robyscar/shagmatic/PICS/power-electronics_box_signal_side.jpg

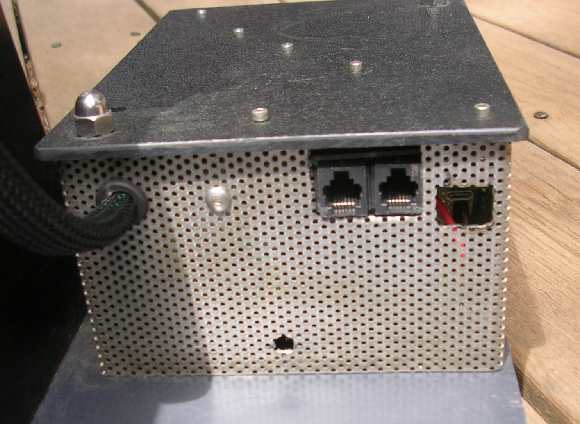
PICS/power-electronics_box_signal_side.jpg
