robyscar/shagmatic/PICS/power_supply_electronics_box_power_entry.jpg

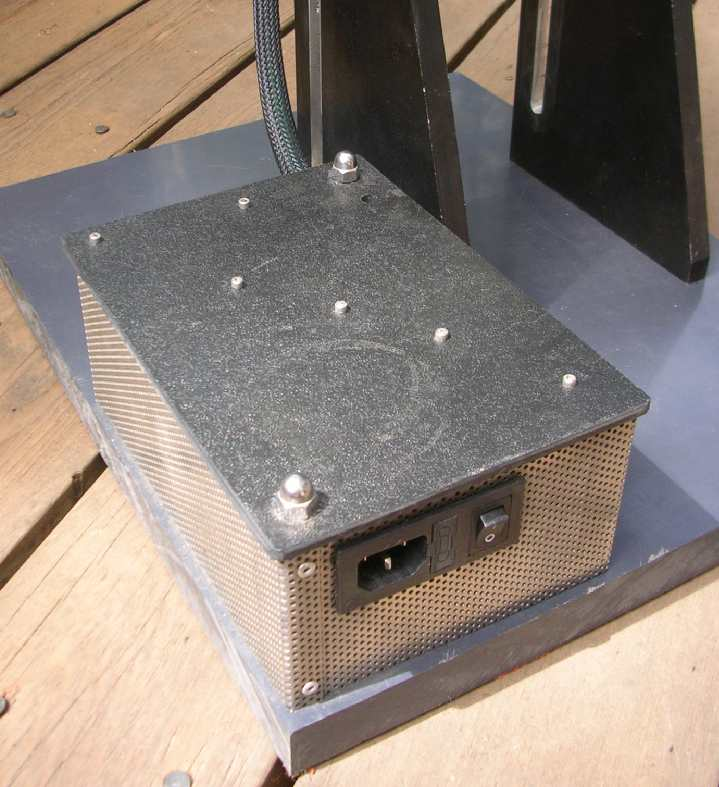
PICS/power_supply_electronics_box_power_entry.jpg
