robyscar/shagmatic/PICS/base.jpg

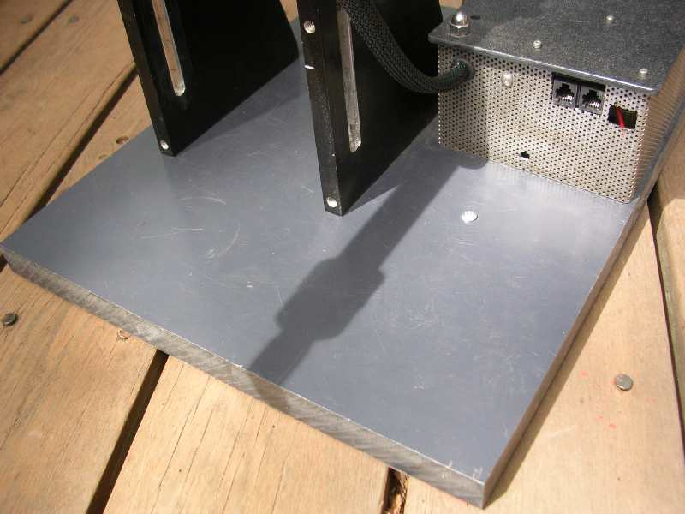
PICS/base.jpg
