robyscar/shagmatic/PICS/clamp_lever.jpg

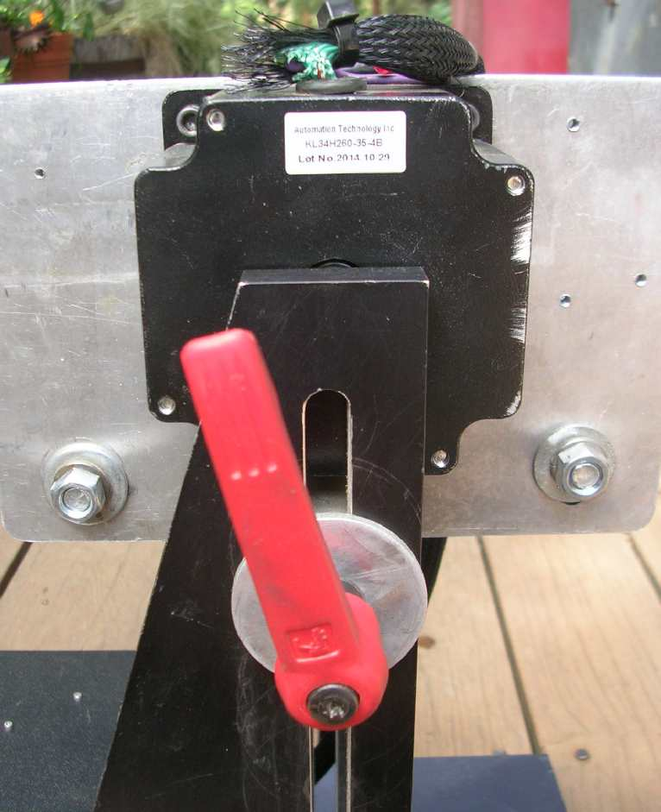
PICS/clamp_lever.jpg
