robyscar/shagmatic/PICS/drive_wheel_limit_switches.jpg

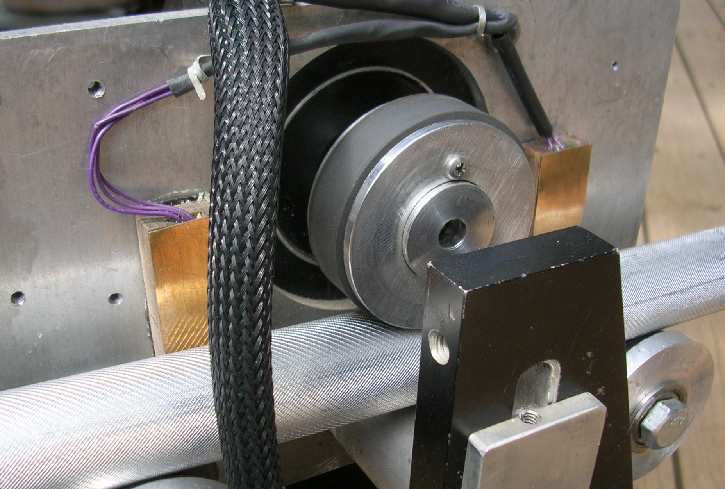
PICS/drive_wheel_limit_switches.jpg
