robyscar/shagmatic/PICS/DSCN2283.jpg

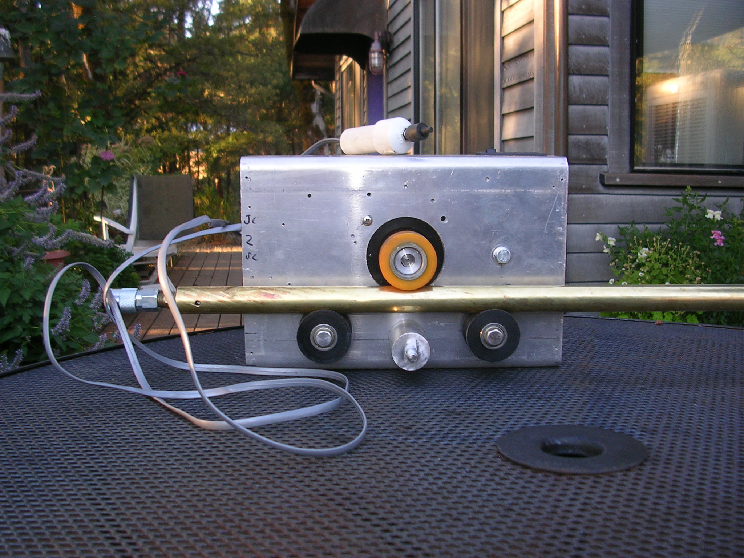
PICS/DSCN2283.jpg
