robyscar/shagmatic/PICS/DSCN2285.jpg

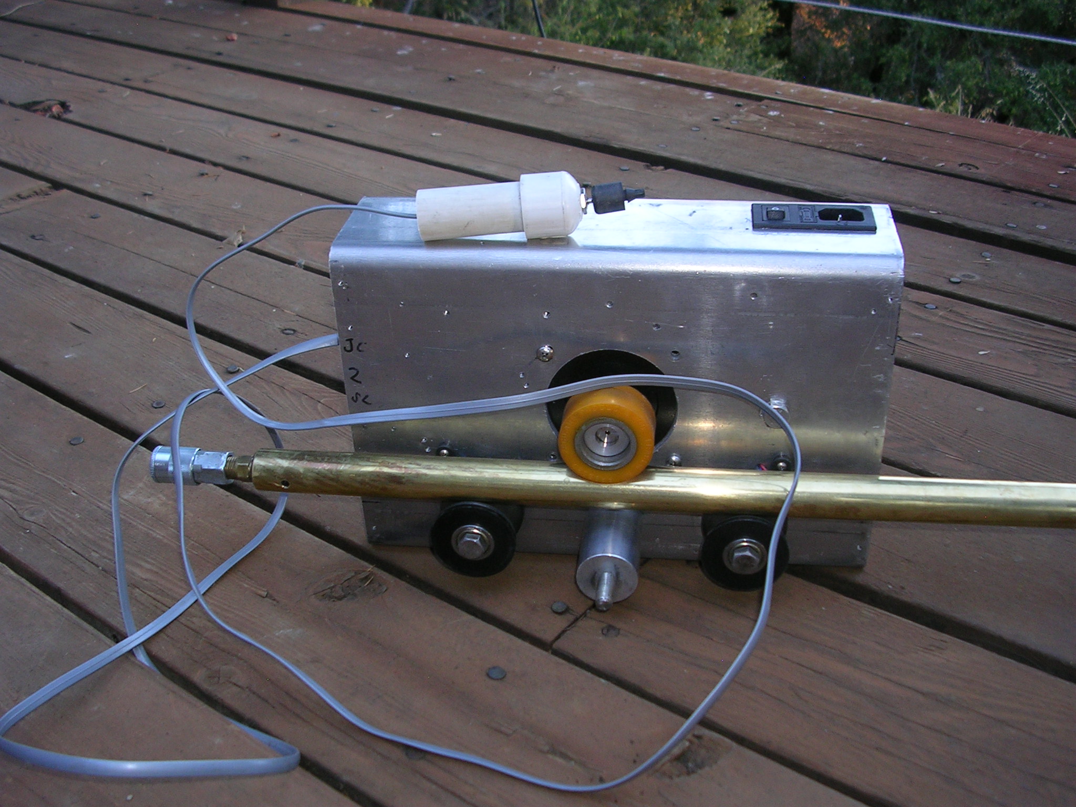
PICS/DSCN2285.jpg
