robyscar/shagmatic/PICS/full_machine_side_1.jpg

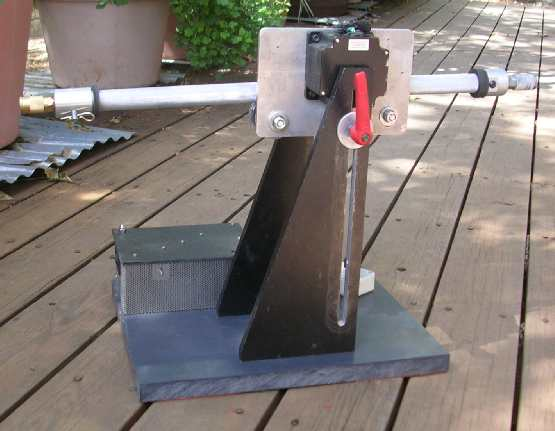
PICS/full_machine_side_1.jpg
