robyscar/shagmatic/PICS/full_machine_side_2 (1).jpg

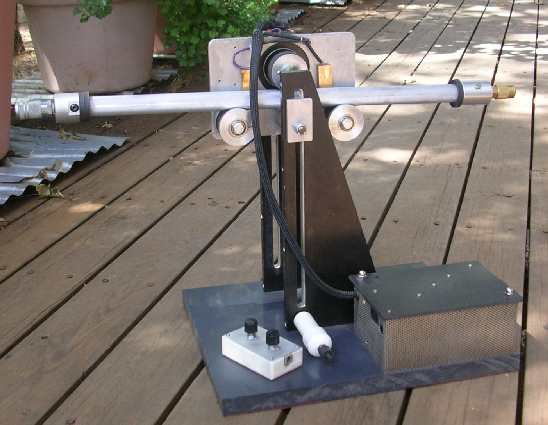
PICS/full_machine_side_2 (1).jpg
