robyscar/shagmatic/PICS/hf-stand2.jpg

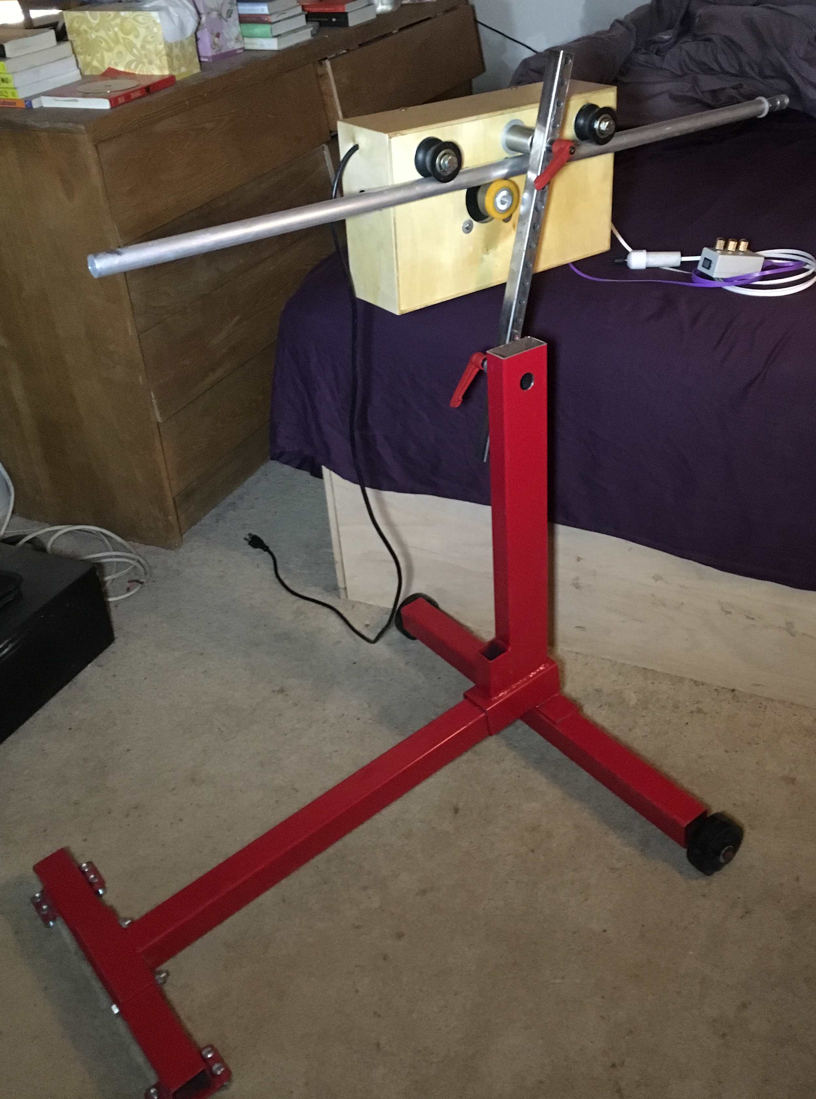
PICS/hf-stand2.jpg
