robyscar/shagmatic/PICS/IMG_1693.jpg

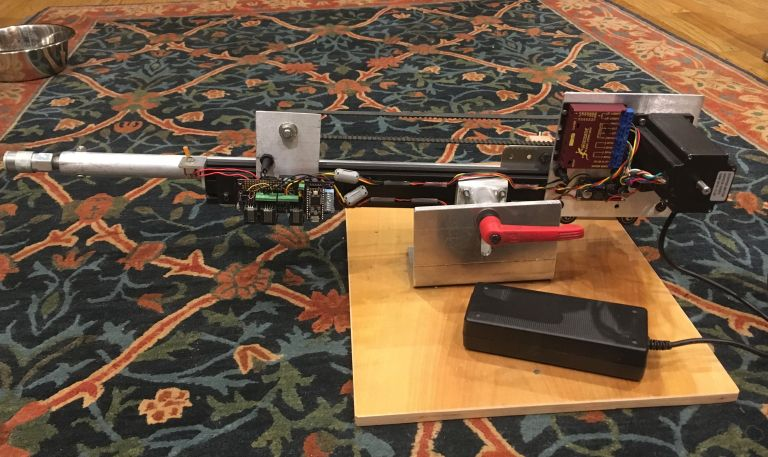
PICS/IMG_1693.jpg
