robyscar/shagmatic/PICS/IMG_1980-small.jpg

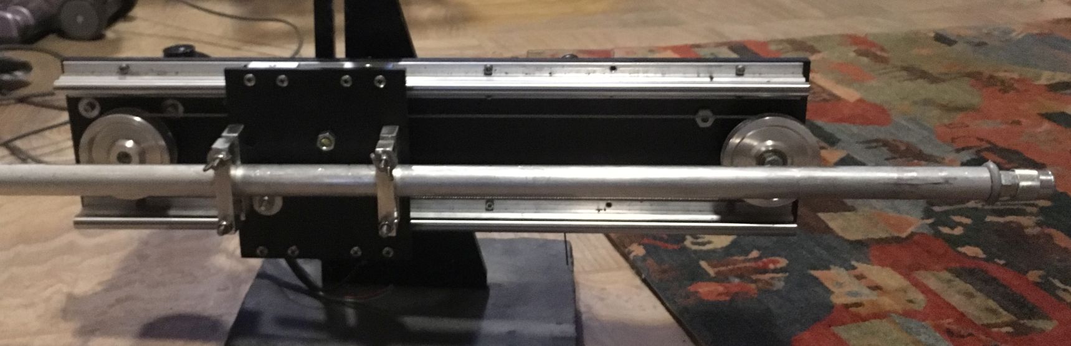
PICS/IMG_1980-small.jpg
