robyscar/shagmatic/PICS/IMG_1981-small.jpg

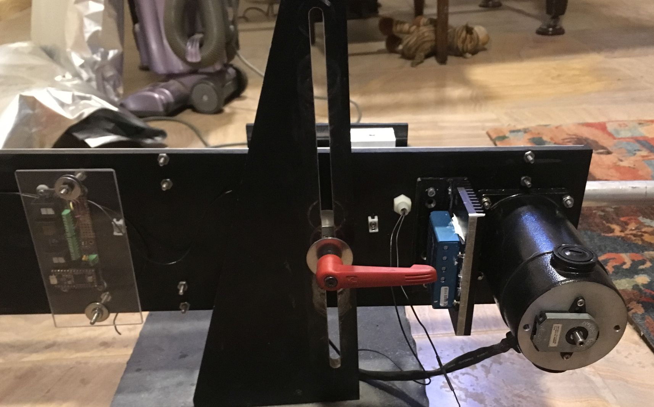
PICS/IMG_1981-small.jpg
