robyscar/shagmatic/PICS/joystick_controller.jpg

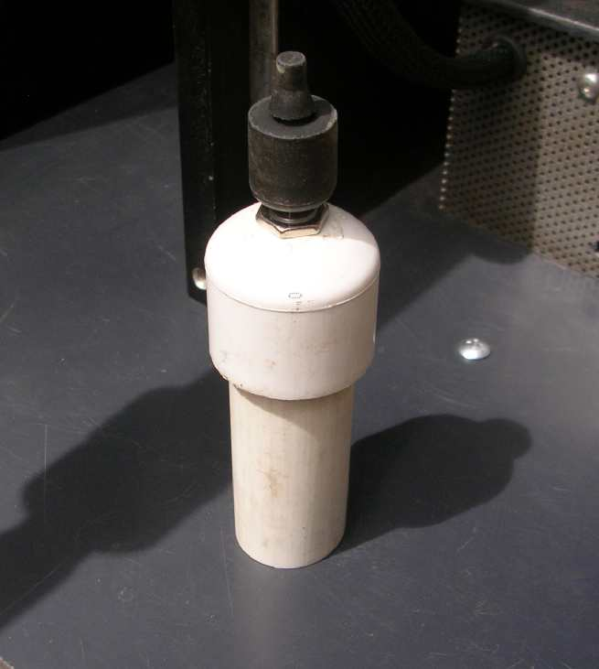
PICS/joystick_controller.jpg
