robyscar/shagmatic/PICS/overall_edited-small.jpg

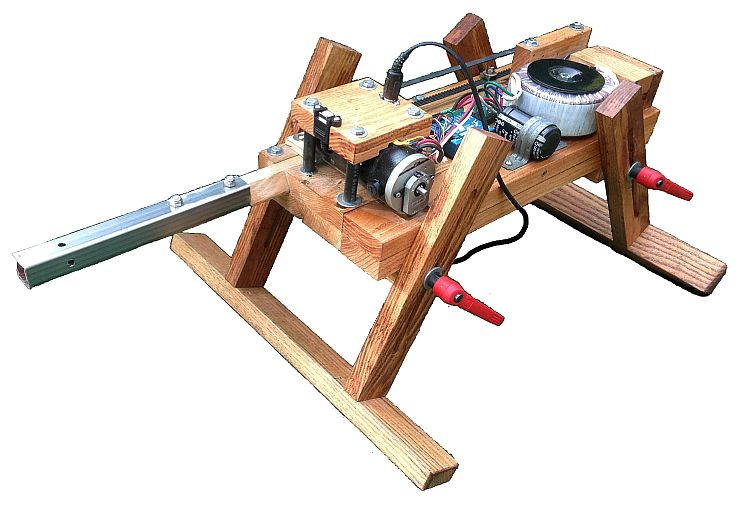
PICS/overall_edited-small.jpg
