robyscar/shagmatic/PICS/screw1-small.jpg

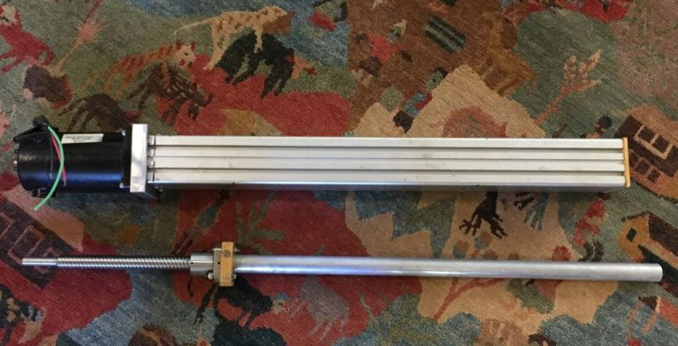
PICS/screw1-small.jpg
