robyscar/shagmatic/PICS/two_knob_control.jpg

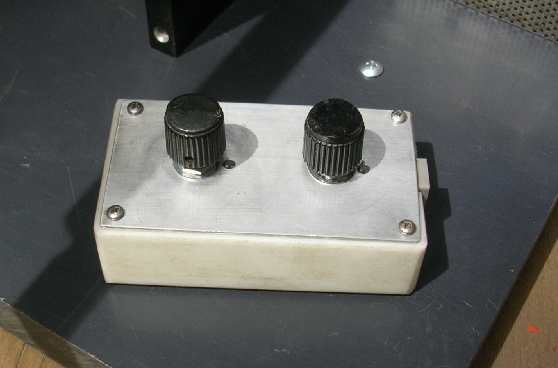
PICS/two_knob_control.jpg
