robyscar/shagmatic/PICS/us2.jpg

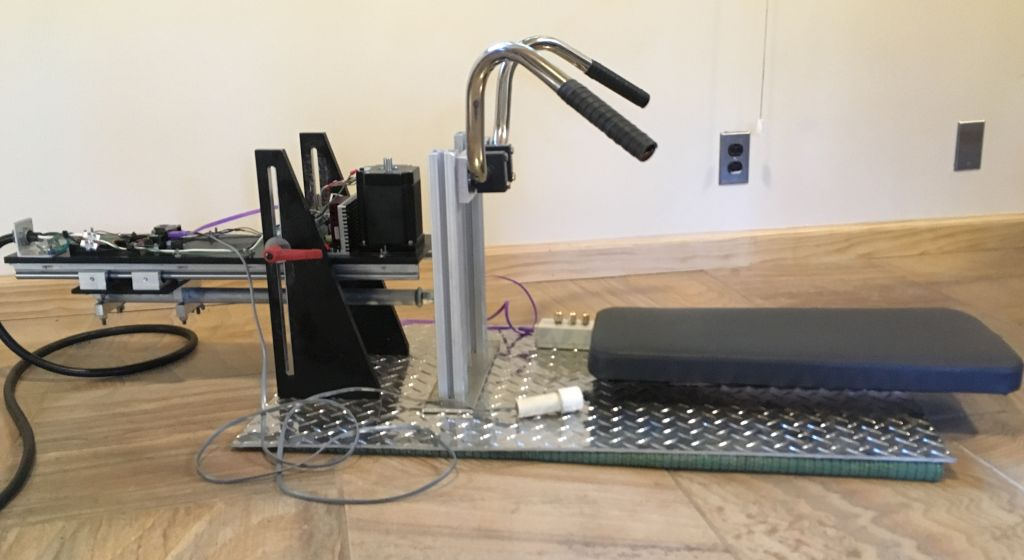
PICS/us2.jpg
