robyscar/shagmatic/BOM/BOM material_list_timiing-belt-version.xls

this is a tentative list with vague descriptions of certain parts to be decided by maker or updated with details in a subsequent revision
description | size model | comments | quantity per unit | notes | supplier | volume price | unit price | system price
NEMA24 566 oz-in Stepper Motor | 24HS39-3008D |  | 1 |  | http://www.omc-stepperonline.com/dual-shaft-cnc-stepper-motor-nema-24-100mm-4nm566-ozin-24hs393008d-p-388.html |  | $59.00 | $59.00
24 or 36 volt switching power supply
XL 18 - 32 tooth timing belt pulley 8mm bore or bore smaller pulley to 8 mm32 works well |  | choose size based on speed desired and other considerations
flange bearings for idler timing belt idler wheel
XL timing belt 3/8 wide choose length for size of machine 185 tooth for 500 mm vee rail |  |  |  |  | mcMaster Carr, Ebay Amazon etc
Vee rail extrusion 500 mm is good for most users | 25142-10 |  | 1 |  | https://www.inventables.com/technologies/makerslide
Vee Wheel Delrin | 25203-01 |  | 4 |  | https://www.inventables.com/technologies/dual-bearing-v-wheel-kit
Eccentric Spacer |  |  | 2 |  | https://www.inventables.com/technologies/eccentric-spacer
Wheel Carriage Plate |  |  | 1 |  | https://www.inventables.com/technologies/standard-wheel-carriage-plate
extrusion nuts for vee rail use 5 mm nuts .8mm pitch |  |  | 10 plus |  | https://www.mcmaster.com/#catalog/122/1936/=15ehlrh
5 mm screws nuts etc for fastening .8mm pitch
G203V or G201X Digital Step Drive (G203 is fully protected) | G320-X |  | 1 |  | http://www.geckodrive.com/geckodrive-step-motor-drives.html |  | $121.00 | $122.00
1" OD tube for drive ram (may be knurled) |  |  | 1 |  | Lowes Home Improvement
bushing to hold quick connect fitting
grommet to hold limit switch magnets in ram tube
RJ11 6 pin 6 wire socket for joystick controller | 623K-6P6C-R (https://www.jameco.com/webapp/wcs/stores/servlet/Product_10001_10001_124039_-1) |  |  |  | jameco
keystone RJ45 connector for 3 knob controller | http://www.digikey.com/product-detail/en/DN-93501-U%2FB/AE10473-ND/2268345
encoders for three knob controller | http://www.digikey.com/product-detail/en/PEC16-2215F-N0024/PEC16-2215F-N0024-ND/3780214 |  | 3
Teensy 3.1 or 3.2microcontroller included in Shagmatic board |  | probably should remove this | 1 | included on controller board | http://pjrc.com
Shagmatic PC board assembled |  |  | 1 |  |  |  |  | $250.00
reed switches in tubular housing for limit switchs 59065-010-ND | 59065-010-ND (https://www.digikey.com/product-detail/en/littelfuse-inc/59065-010/59065-010-ND/43966) |  | 2 |  | digikey
neodynemium (sp) magnets for limit switch | 469-1009-ND digikey |  | 2 |  |  |  | $1.88
misc set screws for drive wheel etc
1 1/2” ABS or copper tube for toy holder |  |  |  |  |  |  |  | $0.50
quick connects for toy holder (harbor freight of other source) |  |  |  |  |  |  |  | $4.00
1/4" close pipe bushing for quick connect to ram |  |  |  |  |  |  |  | $0.75
joystick encoder | EMS22Q51-D28-LT4-ND |  |  |  | digikey |  |  | $41.56
joystick wheel (hood bumper available at auto supplies ) |  |  |  |  |  |  |  | $2.00
1" PVC pipe 4" for joystick housing (buy 2 ft length) |  |  |  |  |  |  |  | $2.00
1" PCV pipe cap for joystick housing preferably with flat ends, not domed |  |  |  |  |  |  |  | $0.35
metal, wood or heavy plastic for box top
wood for box hardwood or baltic birch plywood is recommended
angle metal to connect chassis to base
material for base
nuts washers, spacers and bolt to hold chassis to base
clamp lever for above bolt | http://www.mcmaster.com/#=10wgqu4
