robyscar/shagmatic/BOM/BOM Shagmatic Parts List_12-15-2016.xls

Parts List for the Shagmatic DIY Fucking Machine
Description | Model# / Item# | Comments | Qty | Supplier Link | Unit Price | Notes
Stepper/Transformer Combo Recommendations:
NEMA34 465 oz/in Stepper Motor | KL34H260-60-4A | Great motor for most users | 1 | http://tinyurl.com/j3sop5l | $59.00 | This motor, and the corresponding Power Supply should be fine for the majority of users.
Torroidal transformer, 200VA/22V | AN 2222 | Recommended transformer for the 465 oz/in motor | 1 | http://tinyurl.com/grq84n3 | $32.00 | If you need more power, see the next pairing…
NEMA34 640 oz/in Stepper Motor | KL34H280-55-4A | Higher torque Stepper (For those needing extra 'Ooomph' | 1 | http://tinyurl.com/hfdsdta | $69.99 | If you're goal is to drive a steel spike through a cinder block wall, this motor/transformer setup should do the trick!
Torroidal transformer 300VA/45V | AN 3245 | Recommended transformer for the 640oz/in Motor | 1 | http://tinyurl.com/htlblfp | $36.00 | If you're going to run the higher torque setup and this transformer, we highly recommend ONLY using the Gecko Driver.
Other Power Supply Parts:
Bridge Rectifier (100Volts / 4Amps or higher) | Digikey - GBPC1501FS-ND | There are more options than can be listed… Take note of minimum | 1 | http://tinyurl.com/zgt3z9e | $2.69 | 100V / 4A MINIMUM!
Filter capacitor 10000 mf 100 volt | Bestron 60106401 | There's some leeway on the specs for this… | 1 | http://tinyurl.com/jcm24zu | $14.99 | This has been proven to work reliably and are easy to come by. Feel free to experiment or do your own calculations.
Capacitor bracket | Digikey - RPC1458-ND | Any kind of bracket that will fit the capicitor you get if fine. | 1 | http://tinyurl.com/h237zza | $1.46 | Use 1.25” emt conduit clamp
Power Entry Module, with Fuse and Switch. Snap-In mount. | Adam Tech 2095525 | This particular part is for a snap in unit with switch and fuse | 1 | http://tinyurl.com/zttmjca | $2.95 | This particular module is from Jameco. There are a ton of options out there. We recommend at minimum you install an inline fuse and switch.
Stepper Motor Driver Recommendations:
Gecko Digital Stepper Driver with full protection | G203V | In our opinion, the best driver for this application - Bulletproof! | 1 | http://tinyurl.com/9wl9xyj | $147.00 | If there's a better, more durable stepper driver out there even close to this price range, we're unaware of it. If you find something, please share!
Gecko Digital Stepper Driver, does NOT have full protection | G201X | Essentially same as G203V, but not reverse voltage protected | 1 | http://tinyurl.com/zkbwbu3 | $121.00 | If you're comfortable around electronics, this is a good way to save a few bucks. Just don't hook up the polarity backwards
Automation Technologies Stepper Driver | KL-5056D | Cheaper but watch P.S. Voltage | 1 | http://tinyurl.com/cq8ncb7 | $79.95 | These units do OK, but don't seem as smooth as the Gecko units. They're also very sensitive to input voltage higher than their rating.
Mechanical Drive Parts:
Friction Drive Roller (Urethane) for Stepper Motor | 2475K67 (Yellow) | Requires adapter for 1/2" Shaft | 1 | http://tinyurl.com/jbx3ayv | $25.38 | Feel free to search for other options… We recommend a 2" diameter roller, and Neoprene for it's durability. Softer will provide less slippage.
Alternative to the McMaster-Carr part | RR-215-35-EX500 | similar to the above but 2.5" OD, no adapter required not tested | 1 | https://www.fixtureworks.net/store/pc/1-2-in-ID-Inch-c1690.htm | $25.31 | Shipping to the US from Canada is higher that from McMaster Carr, but no adapter is required, so cost wise it's VERY close.
1" to 1/2" adapter bushing for above |  | Steel, bronze, or aluminum… 1/2" ID x 1" OD x 1" wide | 1 | http://tinyurl.com/gnwk5cv | Varies | As with several items on this list, there are a lot of various options. Please feel free to email us with any questions.
Idler Rollers (Ram Tube guide and support) | Fenner Drives RX0219 | There are other options, see next line… | 2 | http://tinyurl.com/jbof2co | $18.00 | These have been used several times and are very durable, easy to obtain.
Nylon or Delrin...bearing supported, grooved roller | Varies | These can be found on Ebay… Link MIGHT be invalid | 2 | http://tinyurl.com/hexj8hw | Varies | One of our machines uses these rollers, great price and they seem to hold up well. If Ebay link is outdated, just shop their store.
1" OD tubing for ram (may be knurled) Length varies by need. | Varies | Options are wide open on this one… 1" OD x .065 is popular | 1 | http://tinyurl.com/hubobxe | Varies | Aluminum is a great compromise between weight and stiffness. If you're going all out, carbon fiber or titanium is also a possibility!
Neodymium (Rare Earth) magnets for limit switch | Digikey - 469-1009-ND | .375" x .375" - At this point we don't recommend smaller. | 2 | http://tinyurl.com/jtuu64l | $1.88 | A larger magnet is fine, as long as it fits in the ram tube.
Magnetic Reed Switch for detecting the front and rear limits of ram | Digikey - 59065-010-ND (https://www.digikey.com/product-detail/en/littelfuse-inc/59065-010/59065-010-ND/43966) | The threaded housing makes adjustment very simple | 2 | http://tinyurl.com/jnv2s6u | $3.75 | We've had these fail occasionally. We recommend picking up a few spares to have on hand.
Bushing to hold quick connect fitting and magnet for limit switch | Apollo Caster PN-89422 | This is the most recent method we use to hold the magnets | 2 | http://tinyurl.com/hpjxmbd | $1.30 | One used at each end of ram to hold limit switch magnets. Drill and tap these to screw the toy disconnect into.
Quick connect fitting (Female) for ram (1/4" MNPT) | Amflo C21 | Easiest, cheapest method to enable quick toy swaps | 2 | http://tinyurl.com/zlg4cdn | $7.14 | Make sure the male and female parts are the same type. Tip: We suggest using whatever is most common at your local hardware store.
Quick connect fitting for toys (Male) (1/4" MNPT) | Amflo C21 | You'll need one of these for each toy or attachment you use | XXX | http://tinyurl.com/jo3aqts | $4.89 | These can be found dirt cheap at Harbor Freight's if you have any near you. Any Auto Parts store, even Dollar stores will often carry them
Joystick Parts:
Joystick Encoder (High resolution is important!) | EMS22Q51-D28-LT4-ND | Bourns makes quality components! | 1 | http://tinyurl.com/j966t42 | $42.85 | This Encoder has been used several times and has proven itself smooth and reliable. As always though, feel free to experiment.
Joystick wheel (hood bumper available at auto supplies ) | Dorman 45621 | This is a rubber hood/body bumper for cars. | 1 | http://tinyurl.com/j84rj5p | $0.37 | This little piece goes on the end of the joystick encoder for grip when rolling it. Improvise. The rubber part of a dremel sanding drum is perfect!!
RJ11 6 pin 6 wire socket for joystick controller | Jameco - 623K-6P6C-R (https://www.jameco.com/webapp/wcs/stores/servlet/Product_10001_10001_124039_-1) |  | 1 | http://tinyurl.com/h2vn85l | $1.25 | Harder to find item. Jameco's price is very good. Digikey offers them, but about twice the cost of Jameco currently.
RJ11 cord - 14ft, Coiled | Digikey - A2662R-14C-ND | Once again, this is wildly variable… buy what works for you but be sure it is a reversed cable | 1 | http://tinyurl.com/jeqrpbd | $7.76 | Just order whatever length and style suits you. MAKE SURE CONNECTORS ARE REVERSED NOT STANDARD ! Coiunterintuitive but reversed means wired straight through.
1" PVC pipe 4" for joystick housing (buy 2 ft length)
1" PVC Pipe Cap for joystick housing |  |  |  |  |  | If you can't find a cap with a flat top, you can sand or file a flat spot in the center when the encoder mounts.
3-Knob Controller Parts:
Keystone RJ45 connector for 3 knob controller | Digikey - AE10473-ND (http://www.digikey.com/product-detail/en/DN-93501-U%2FB/AE10473-ND/2268345) | This is to connect the 3-knob controller to the CAT-5 cable | 1 | http://tinyurl.com/h8vw3lr | $2.39 | This connector will work for most people. If you're controller design requires a different connector, it shouldn't be a problem.
Encoders for three knob controller | Digikey - PEC16-2215F-N0024-ND | These are 24-step/revolution units. | 3 | http://tinyurl.com/jqbq7a8 | $1.16
Handheld enclosure box | Digikey - 377-2068-ND | This is a good, all around box, but the skys the limit. | 1 | http://tinyurl.com/hl3fysm | $2.10
Miscellaneous Items:
3/8" or 1/2" bolts, nuts etc. to mount idlers
Set screws for drive wheel (May be included)
1 1/2” ABS or copper tube for toy holder
Material for enclosure, base, support, etc… (Wood, Aluminum, etc)
Miscellaneous hardware… Will vary by builder and design.
