robyscar/shagmatic/PICS/quick_connect_assembly.jpg

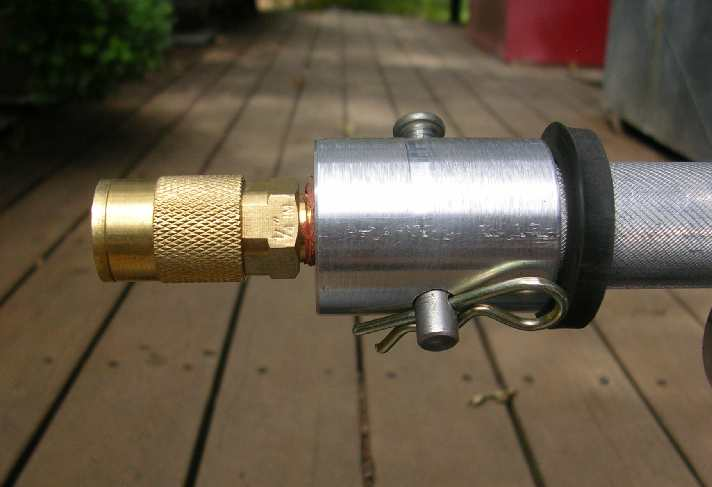
PICS/quick_connect_assembly.jpg
